joshsowalsky/sourdough-sensor-box/render_exploded.png

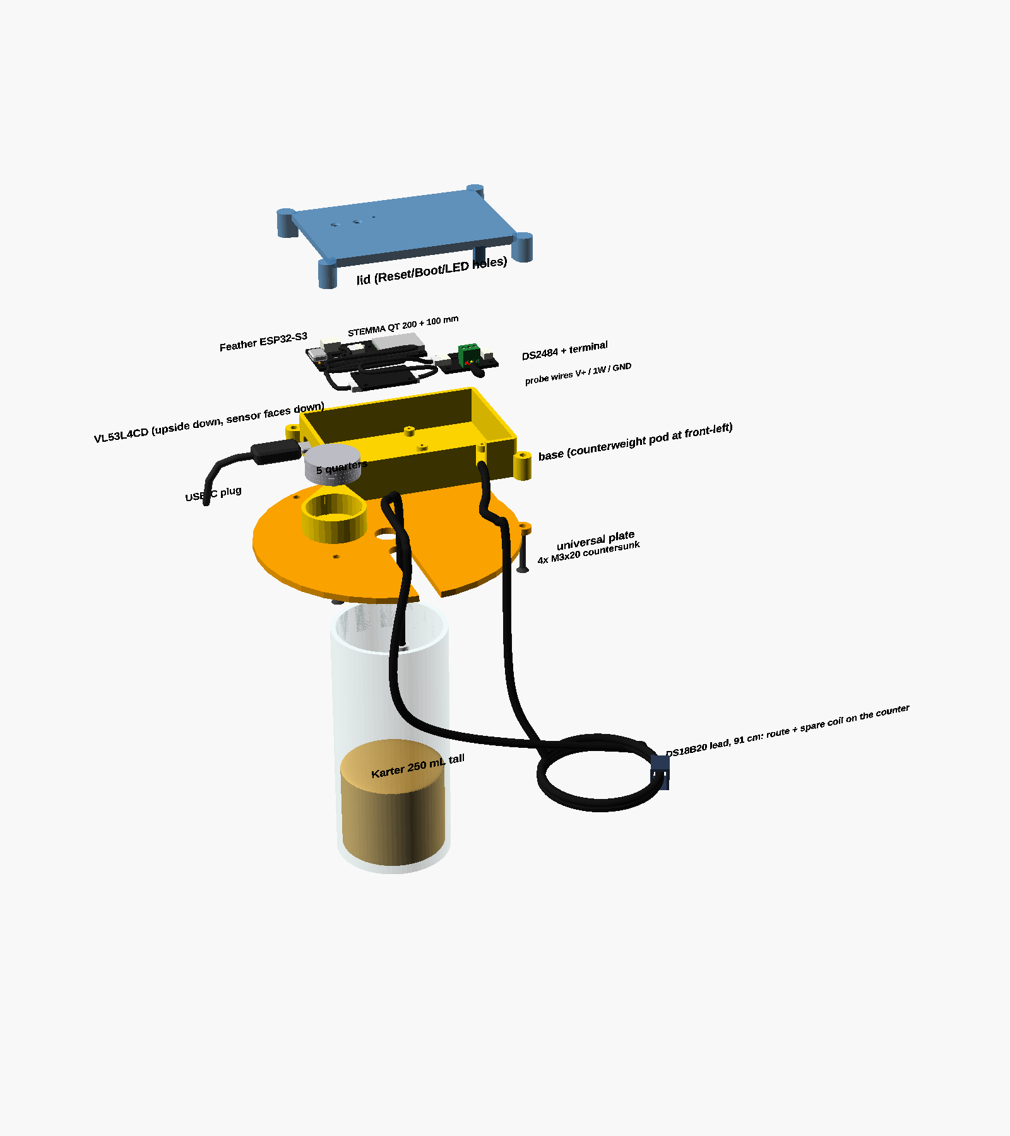
render_exploded.png
