joshsowalsky/sourdough-sensor-box/render_nolid.png

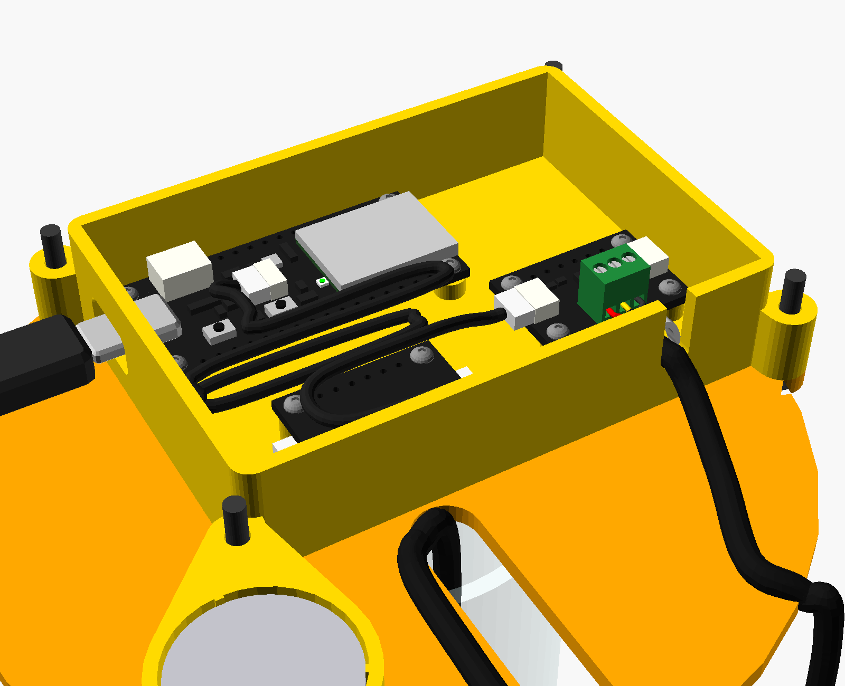
render_nolid.png
