joshsowalsky/sourdough-sensor-box/print-files/base.stl

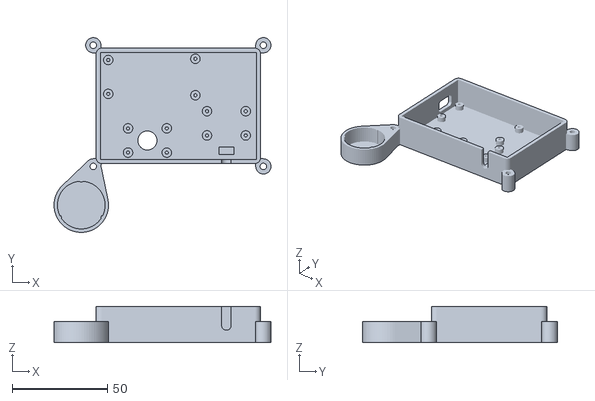
[picture p3: CAD file, 2026-10-11]
print-files/base.stl
113.8 x 102.1 x 19.0
