joshsowalsky/sourdough-sensor-box/print-files/v5-print-set/0-all-three-parts-one-plate.stl

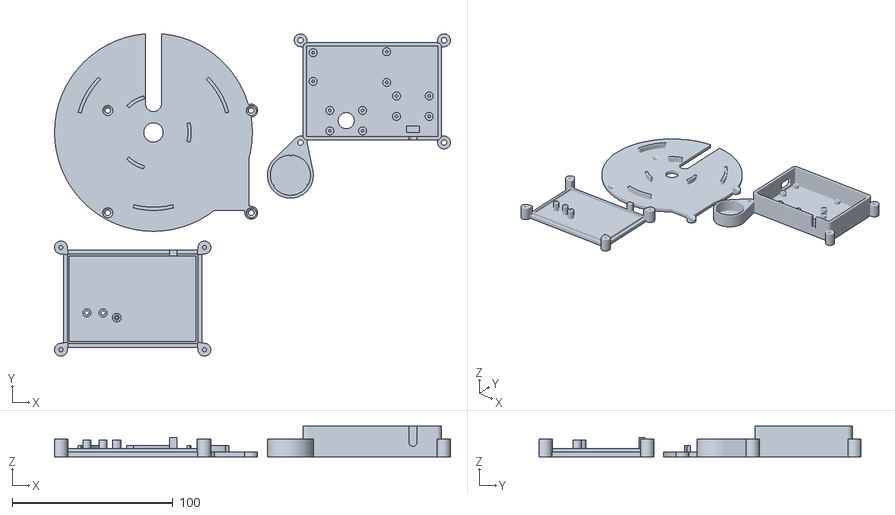
[picture p4: CAD file, 2026-10-23]
print-files/v5-print-set/0-all-three-parts-one-plate.stl
246.1 x 200.3 x 19.0
