joshsowalsky/sourdough-sensor-box/print-files/v5-print-set/1-collar.stl

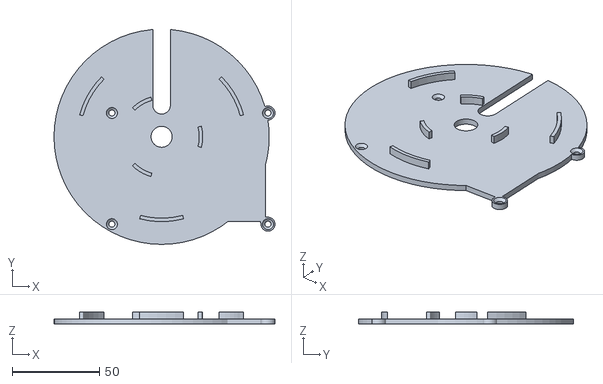
[picture p5: CAD file, 2026-10-11]
print-files/v5-print-set/1-collar.stl
126.3 x 122.8 x 7.00
