joshsowalsky/sourdough-sensor-box/print-files/v5-print-set/3-lid.stl

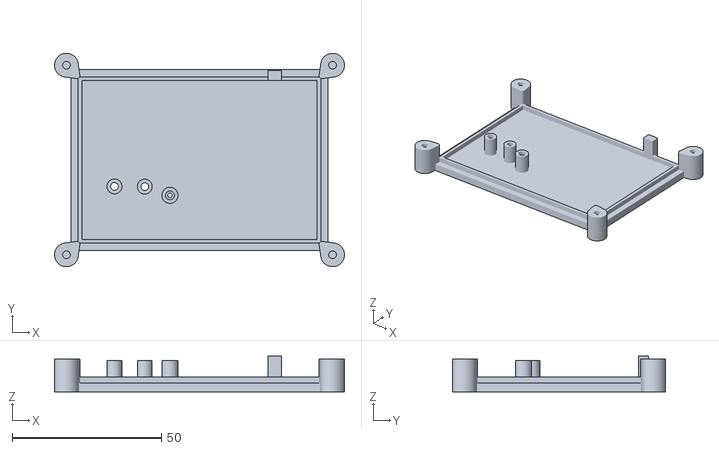
[picture p6: CAD file, 2026-10-11]
print-files/v5-print-set/3-lid.stl
97.2 x 71.5 x 11.9
