joshsowalsky/sourdough-sensor-box/(list of files, cad)

Other CAD files:
print-files/v5-print-set/2-base.stl
