joshsowalsky/sourdough-sensor-box/render_assembled.png

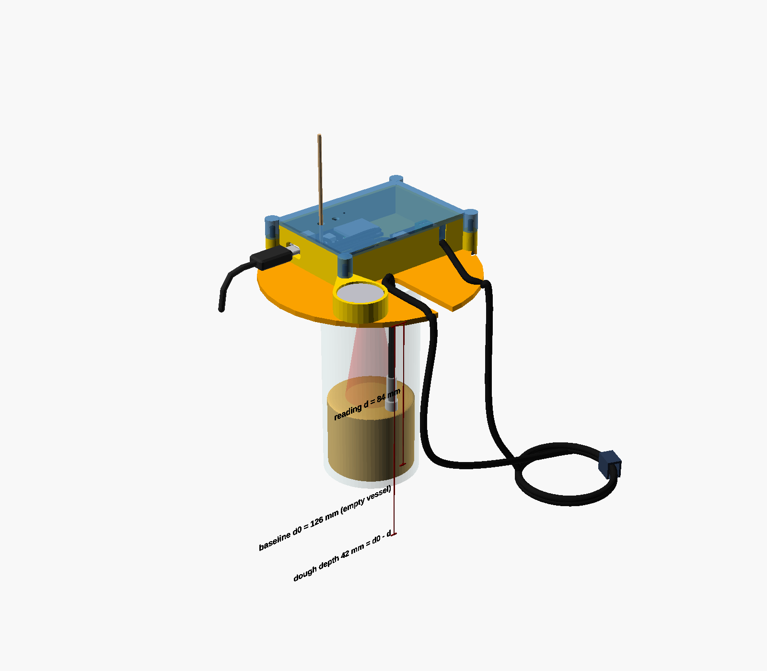
render_assembled.png
