joshsowalsky/sourdough-sensor-box/(commit log)

2026-10-11 Add 3D viewer, print files and renders
    [base.stl, collar.stl, lid.stl]
2026-10-11 Print plate viewer: parts laid out on the 256 mm P2S plate, nav links between views
2026-10-13 Add live sensor readings page
2026-10-23 Add v5 base (deeper M2 pilots), v5 scad and changelog; v4 files kept
    [base_v5.stl, enclosure_v5.scad]
2026-10-23 Add v5 print set: one-plate file, separate parts, notes, and zip
    [0-all-three-parts-one-plate.stl, 1-collar.stl, 2-base.stl, 3-lid.stl]
2026-11-01 Add Feather and bridge code with Wi-Fi readings and setup mode
    The Feather now posts its readings over Wi-Fi to the PC bridge as well as
    over USB, and opens a Sourdough-Setup network for adding Wi-Fi from a phone
    when it can't find a known one. The bridge accepts readings either way.
    settings.toml stays on the board and is git-ignored.
2026-11-01 Publish readings from the Feather straight to GitHub
    The Feather now writes latest.json to the data branch itself once a minute,
    so the live page works on any Wi-Fi without the PC. It streams the existing
    history in and builds the upload in one pre-sized buffer to fit the board's
    memory. The PC bridge stands by while the Feather reports publishing and
    takes over if it stops.
2026-11-01 Add safety nets so the Feather recovers on its own
    Re-runs the program after any error, restarts after five GitHub save
    failures in a row (clears fragmented memory; history reloads from GitHub),
    and arms a 5-minute hardware watchdog when not on USB.
    [code.py]
2026-11-01 Move the Feather to Arduino firmware with Wi-Fi updates
    CircuitPython hung in its own C layer about 30 minutes after each Wi-Fi
    join and in low-memory HTTPS uploads, out of reach of Python and its
    watchdog. The Arduino sketch keeps the same bridge lines and latest.json,
    adds a hardware watchdog with a note of where it stopped, its own live
    page, setup mode, and updates and restarts pulled from the firmware
    branch with a SHA-256 check and a fallback to the previous build.
    The CircuitPython version stays in feather/ with the diagnostics used to
    find the hang; the bridge now logs the board's messages.
    [partitions.csv]
2026-11-01 Ignore Arduino build output
    [partitions.csv]
2026-11-02 live page: show the current run since its feed
    The PC logger publishes the latest feed and every reading since it to
    run.json on the runs branch; the page draws it as This run.
2026-11-02 Pause/resume tracking button (talks to the ToF logger on the home PC)
2026-11-02 Pause button works from anywhere: sends through a private ntfy topic saved on the phone
2026-11-02 Rising threshold relative to the vessel; status headlines that don't read as 'not rising'
    A flat 0.3 cm was 1.2x in the Karter but 1.25x in the wider Pyrex, so the
    page said 'no rise' through two hours of rising. Now 1.15x, at least 0.2 cm.
2026-11-03 Swap flow on the dashboard: Calibrate empty jar, then Starter in
    While paused, Calibrate measures the empty jar (~10 s; the logger answers on
    the private control topic) and Starter in starts a new feed like the last
    one. A measured empty jar sets the starting depth instead of the catalog.
2026-11-03 Feed table: the new feed is the current one even before its first reading
2026-11-03 Feed planner: pick when you want the peak and the room temp, get a ratio
    Fit from this starter's last finished feed (hours to peak per doubling,
    corrected 2x per 15F). Opens on the feed just done, so the current ratio
    comes back unchanged.
2026-11-03 Status: peak estimate once it has risen for 2 h (onset + past onset-to-peak, and current climb rate)
2026-11-04 Starter in grams follow the feed planner's pick until typed; Use in Starter in button
2026-11-04 Starter in: jar and flour dropdowns with + Add…, remembered in this browser
2026-11-04 Peak forecast card: before-the-rise guess from past speed, live fit to every reading, replayed trail, track record, learned bias and lean
2026-11-04 Strength chart: faster plots higher (axis flipped), ready band on top, '↑ faster' label
2026-11-05 Status banner: green '✓ Doubled' state instead of 'Rising: not ready yet'; one slowing measure shared by banner, outlook and forecast
2026-11-05 Status banner: green '✓ At its peak' when a doubled starter levels off, instead of orange 'Feed soon'
2026-11-05 Jars: after Calibrate, ask which jar it was; ✓ marks calibrated jars; a 'Your jars' table from the feed log
2026-11-05 New jar is a two-step flow (calibrate, then name; or cancel); picking a known jar after a calibration checks the reading against it; Starter in needs a named jar
2026-11-05 Calibration: say a reading isn't saved until Starter in; Discard reading / Undo (Starter in then keeps the jar's saved value)
2026-11-05 Jar box rewrite: the one place to calibrate (Calibrate / Recalibrate / Calibrate again + Discard), any order, 'Remember it for this jar' tick box; status card loses its Calibrate button; jar table ke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
2026-11-05 Fix: Calibrate reset the Jar picker to the last feed's jar (the pause looked new); the form is now keyed by when the pause started and the pick survives reloads
2026-11-05 Peak forecast: feed chips (This feed + every past feed), tappable track-record rows open a past feed's replayed charts; the card stays up with the chips while a new feed waits for readings
2026-11-05 Bake tab: is Gus ready (strength, where it is in its peak window, enough of it), step-by-step with Done buttons and times that follow, and what matters for the loaf
2026-11-05 Bake tab: Done and Undo always redraw (the tapped button had focus, so the list skipped redrawing)
2026-11-06 Bake tab: bulk follows the temperature since the mix, from the PC's plan
    The PC now pushes a reminder for each step from the salt to the fridge.
    Folds count from the last Done; the end of bulk counts from the mix at the
    measured temperature, so the page shows the same estimate as the pushes.
2026-11-06 Bake tab: dough mode, the sensor box measuring the dough's rise
    Measure the empty tub, then 'Box is on' after mixing; the PC pauses Gus's
    tracking, measures the rise against the settled dough (skipping the minutes
    after each fold) and the bulk step shows 'up X% since mixing'.
2026-11-06 Feed planner: typed Gus is capped at what fits the jar
    With Gus typed in Starter, the ratio never exceeds what the chosen jar holds
    with room for a 2.5x rise (from the mL in its name), and says so. Lock ratio,
    which the page remembers, no longer switches typed Gus off.
2026-11-06 Live page: no stale 'paused' after a reload, no cards jumping in
    raw.githubusercontent.com serves run.json up to 5 minutes old regardless of query, so a reload right after Starter in showed paused. The page now also reads it through the GitHub API on load and after a button, keeps the pressed button across reloads, and hides the cards until the data is in.
2026-11-06 Live page: Edit this feed
    Correct the grams of the current feed from the run card; the PC rewrites it and republishes at once. Flour's breakdown scales with the new flour grams.
2026-11-07 Starter: big Into the fridge button (a pause that says In the fridge)
2026-11-12 Bake: autolyse length and experience level; bread clock counts both
    Autolyse (none, 30 min, 1 h, 2 h) adds a flour-and-water step before Gus
    goes in; bulk still counts from Gus. The bread clock shows the autolyse,
    when bulk starts and how long it runs, using the same bulk formula as the
    Bake tab. Level: experienced shows short steps and hides long notes on
    both tabs. The planner and bread clock can now learn from the current feed
    once it has peaked, so the first feed out of the fridge isn't left with
    nothing, and a paused feed that just peaked says mix now.
2026-11-13 Bake tab: the fridge step's button says It's in the fridge
2026-11-13 Bake tab: Start preheat / It's in the oven / It's out buttons, with live oven clocks
